megatron0000/solaris/estruturas/dual-axis-tracker/solartracker-bottom.dxf

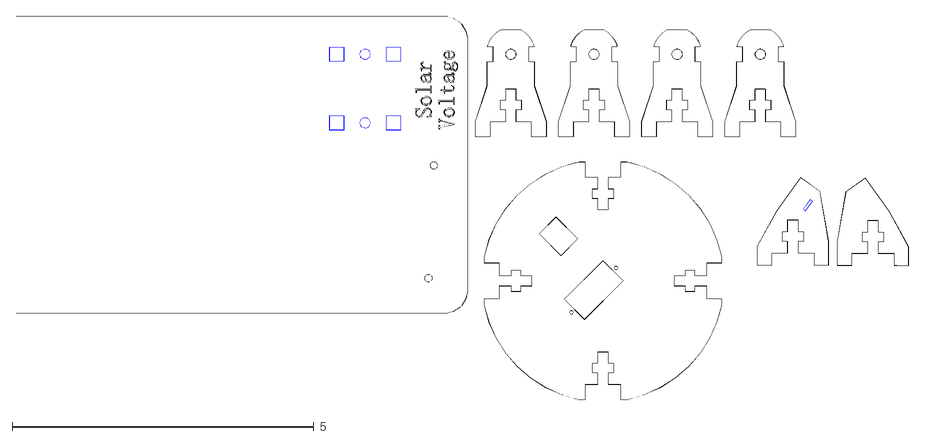
[picture p10: CAD file, 2017-06-11]
estruturas/dual-axis-tracker/solartracker-bottom.dxf
14.8 x 6.35
