megatron0000/solaris/estruturas/dual-axis-tracker/solartracker-top.dxf

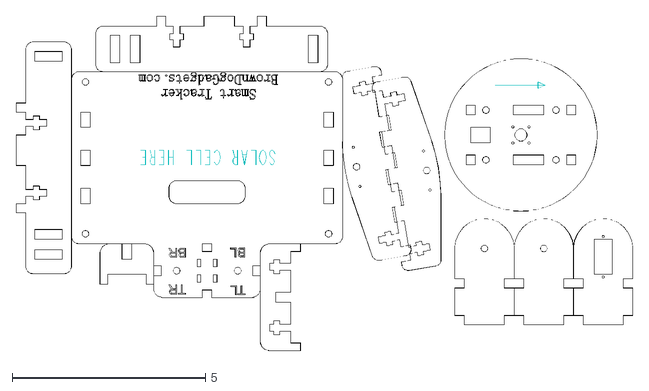
[picture p11: CAD file, 2017-06-11]
estruturas/dual-axis-tracker/solartracker-top.dxf
15.9 x 8.64
