megatron0000/solaris/estruturas/dual-axis-tracker/how-to-build.pdf

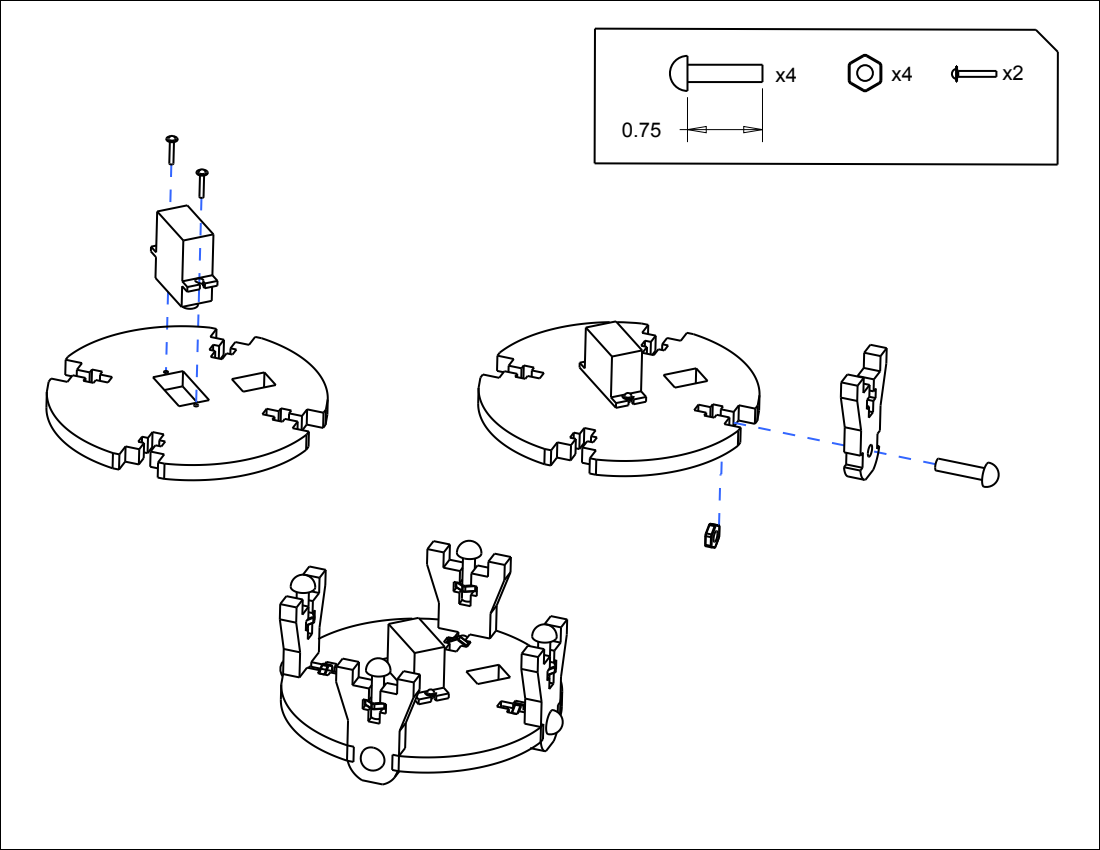
[picture p12: page 1]

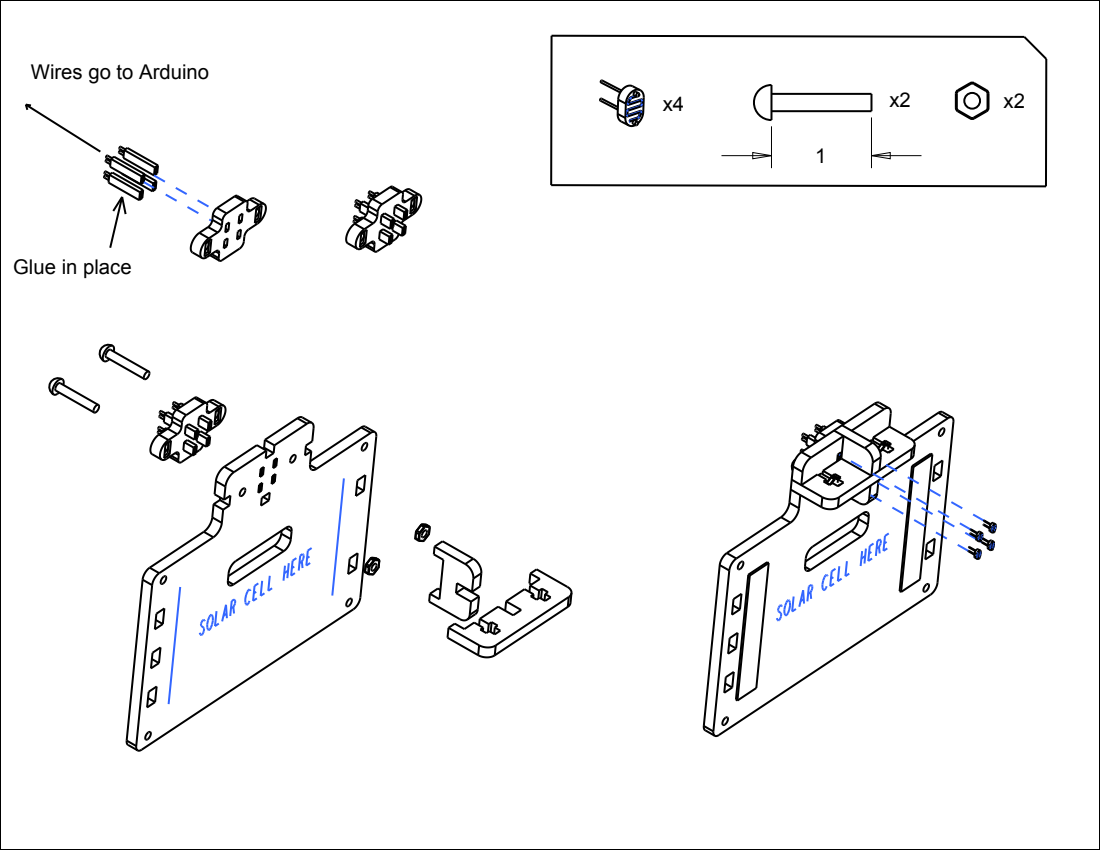
[picture p13: page 2]

Wires go to Arduino

Glue in place

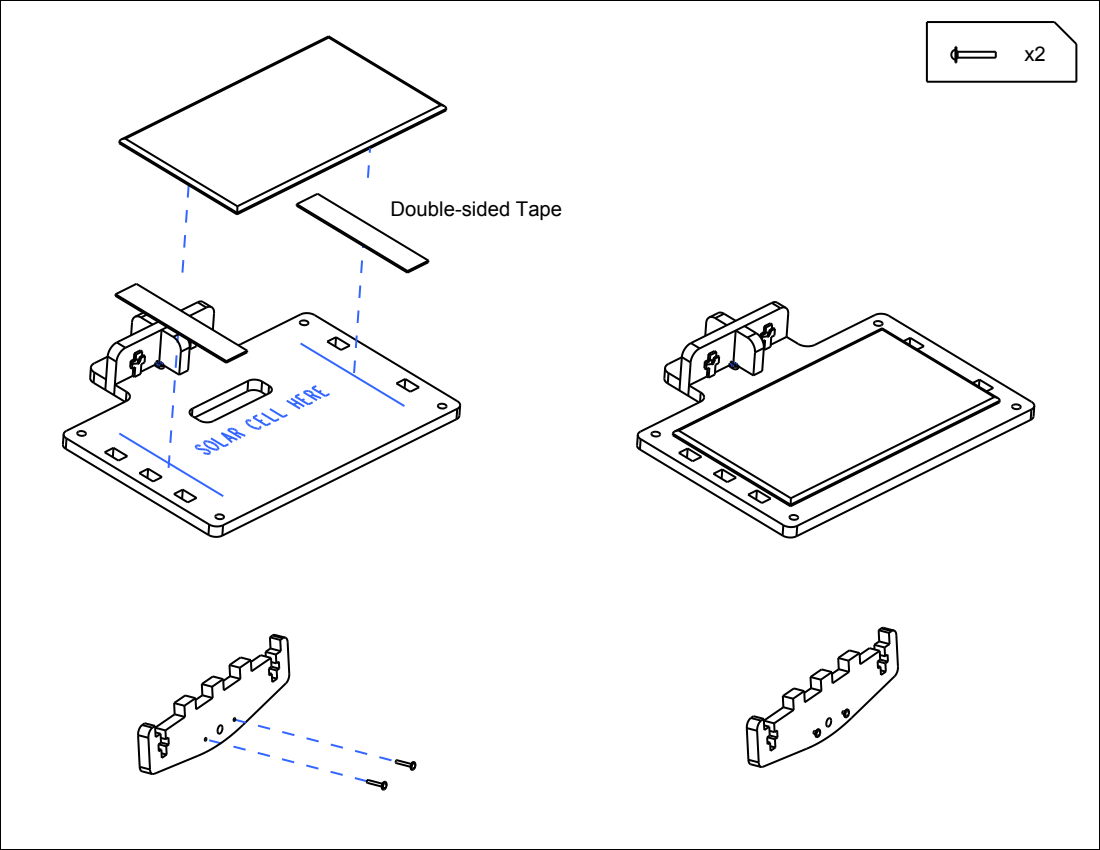
[picture p14: page 3]

Double-sided Tape

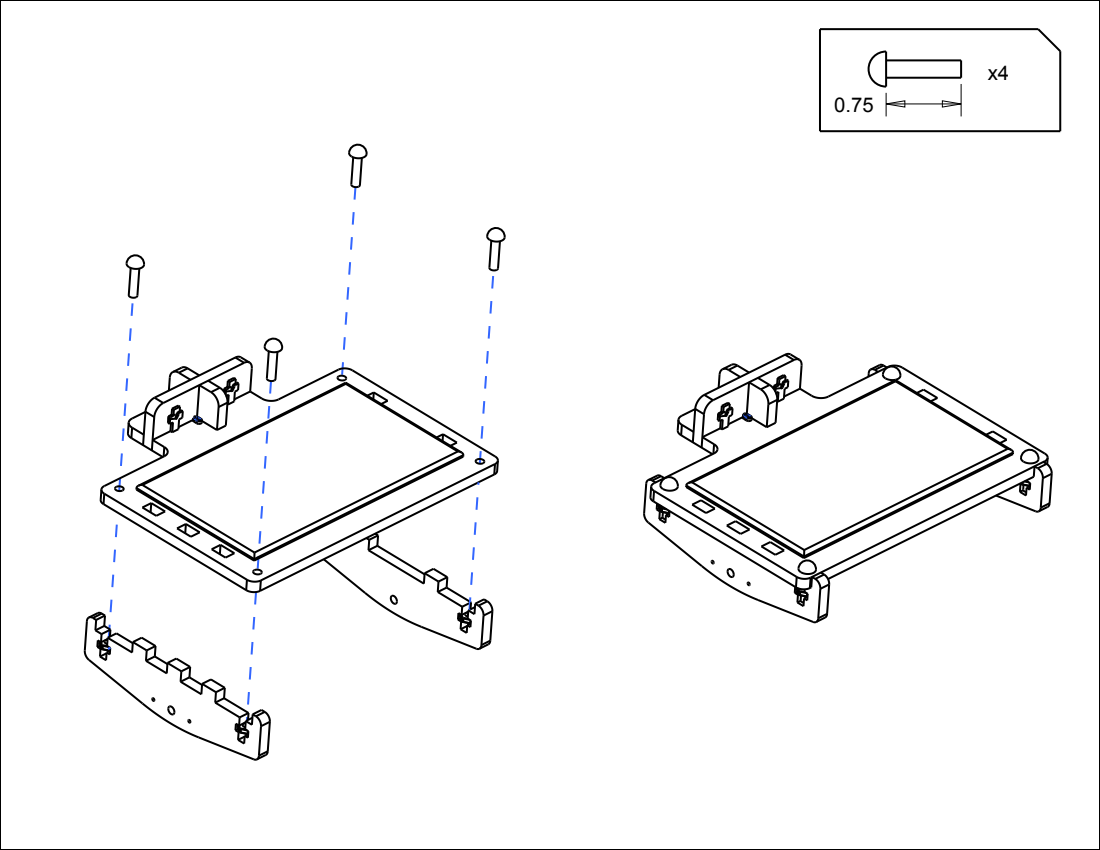
[picture p15: page 4]

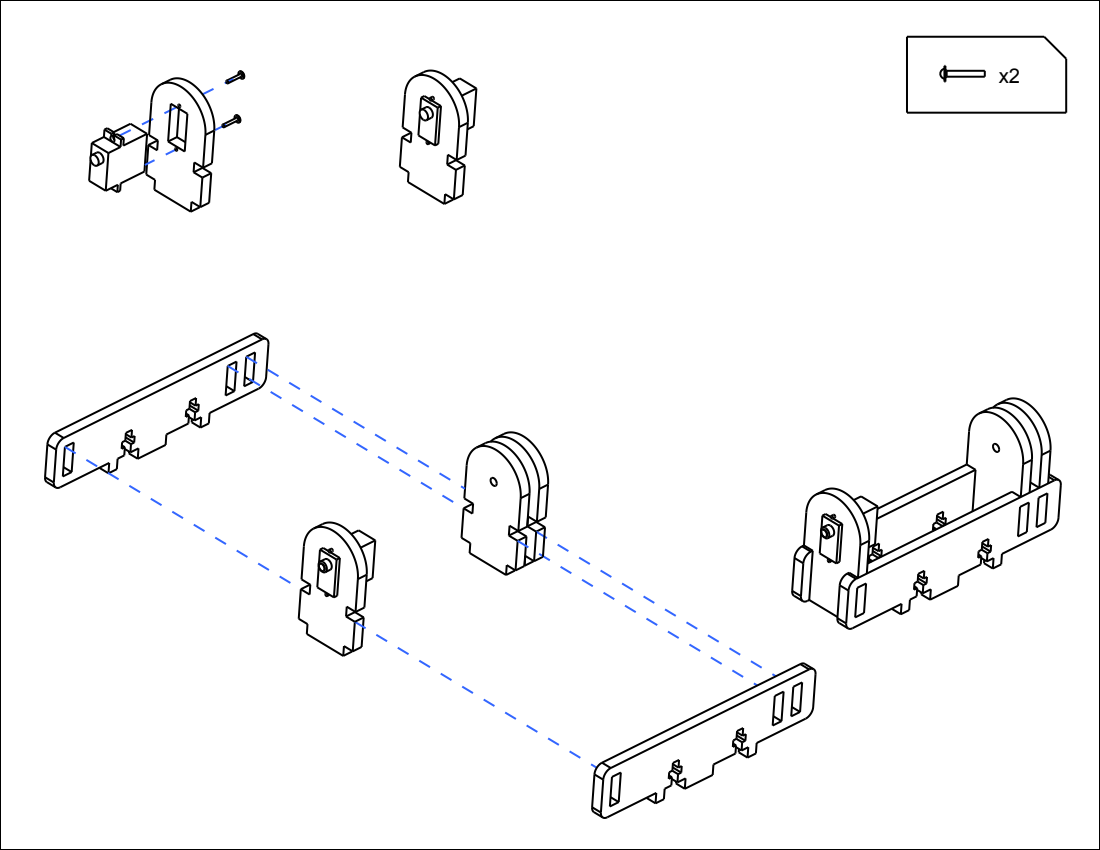
[picture p16: page 5]

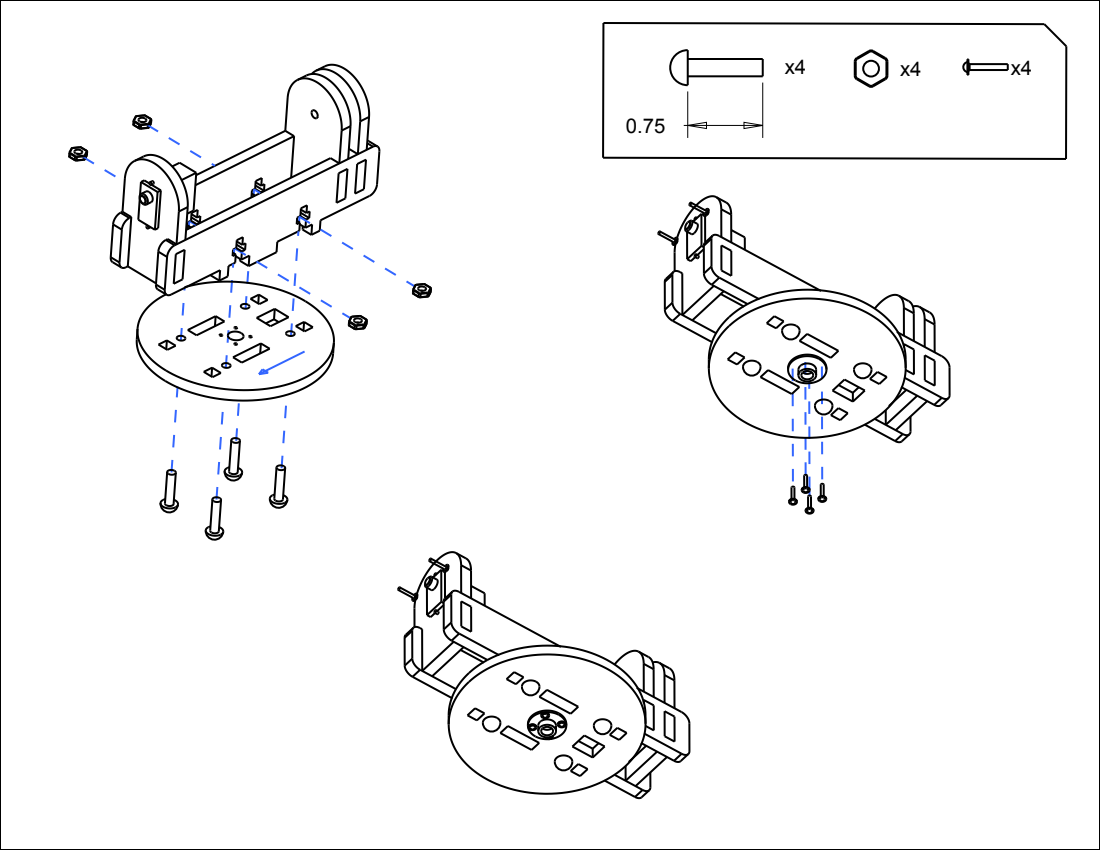
[picture p17: page 6]

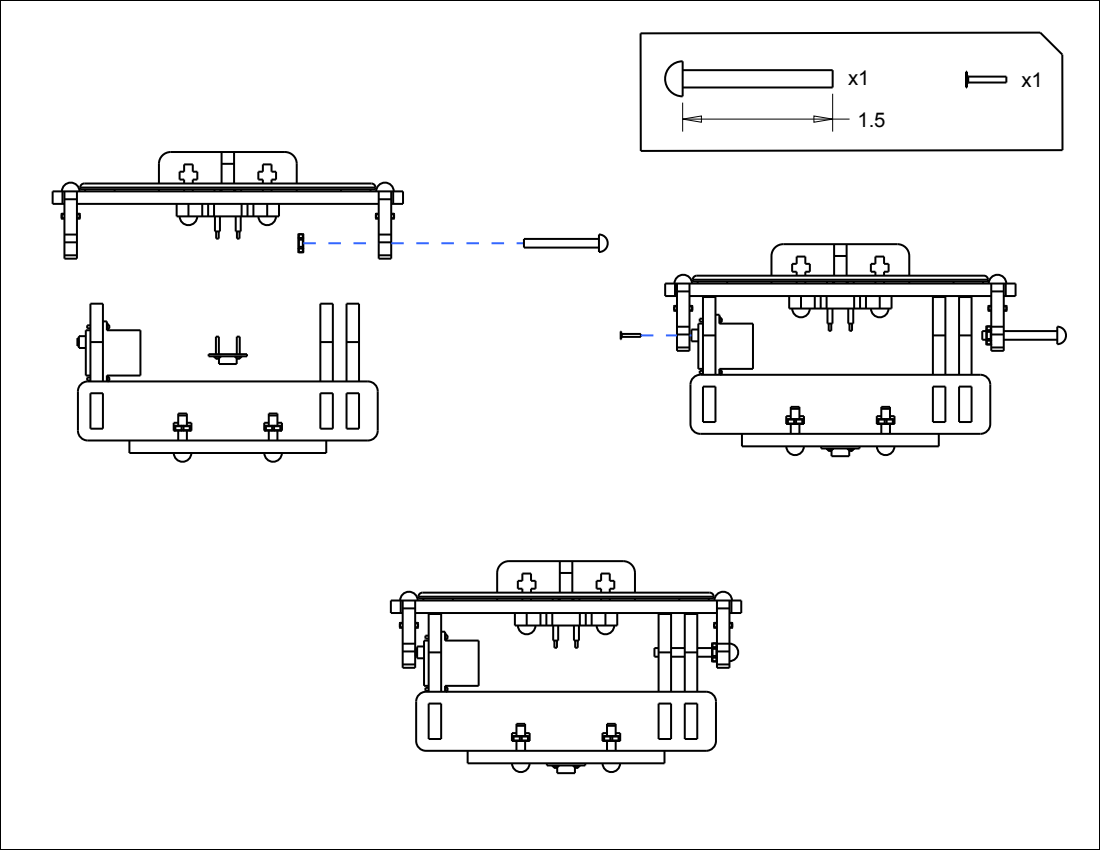
[picture p18: page 7]

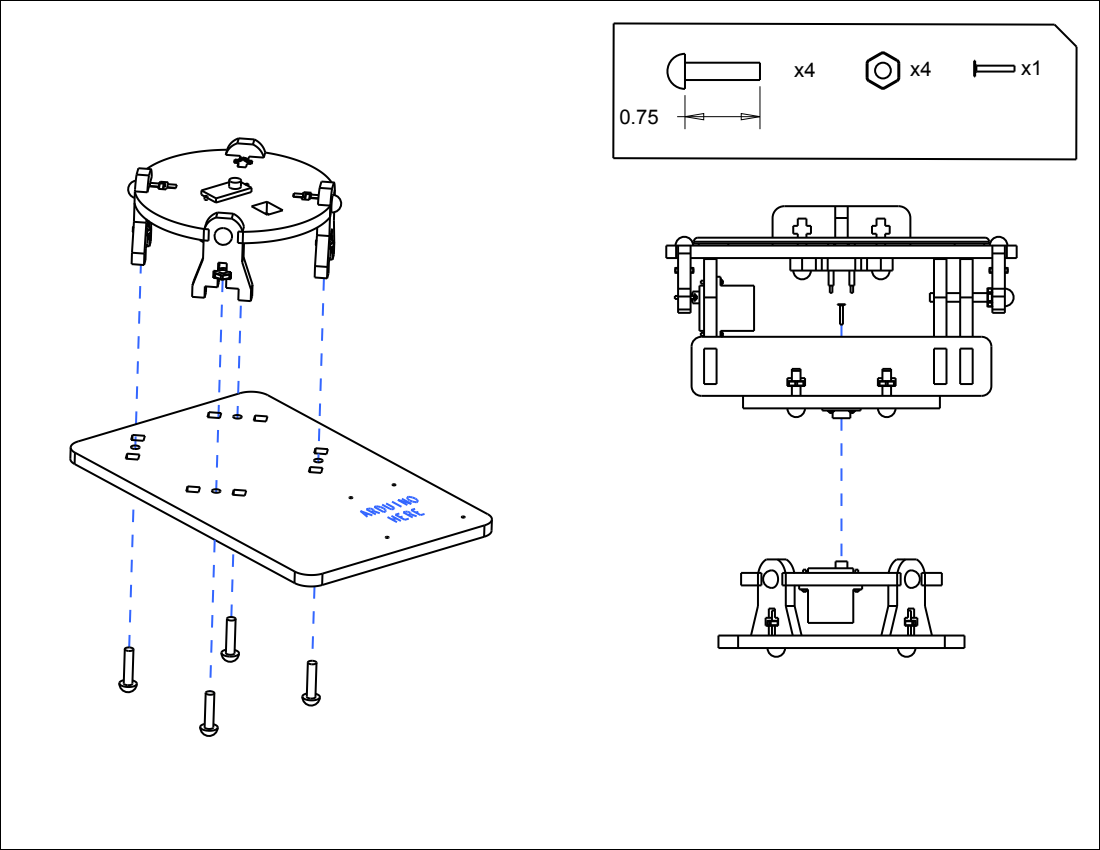
[picture p19: page 8]

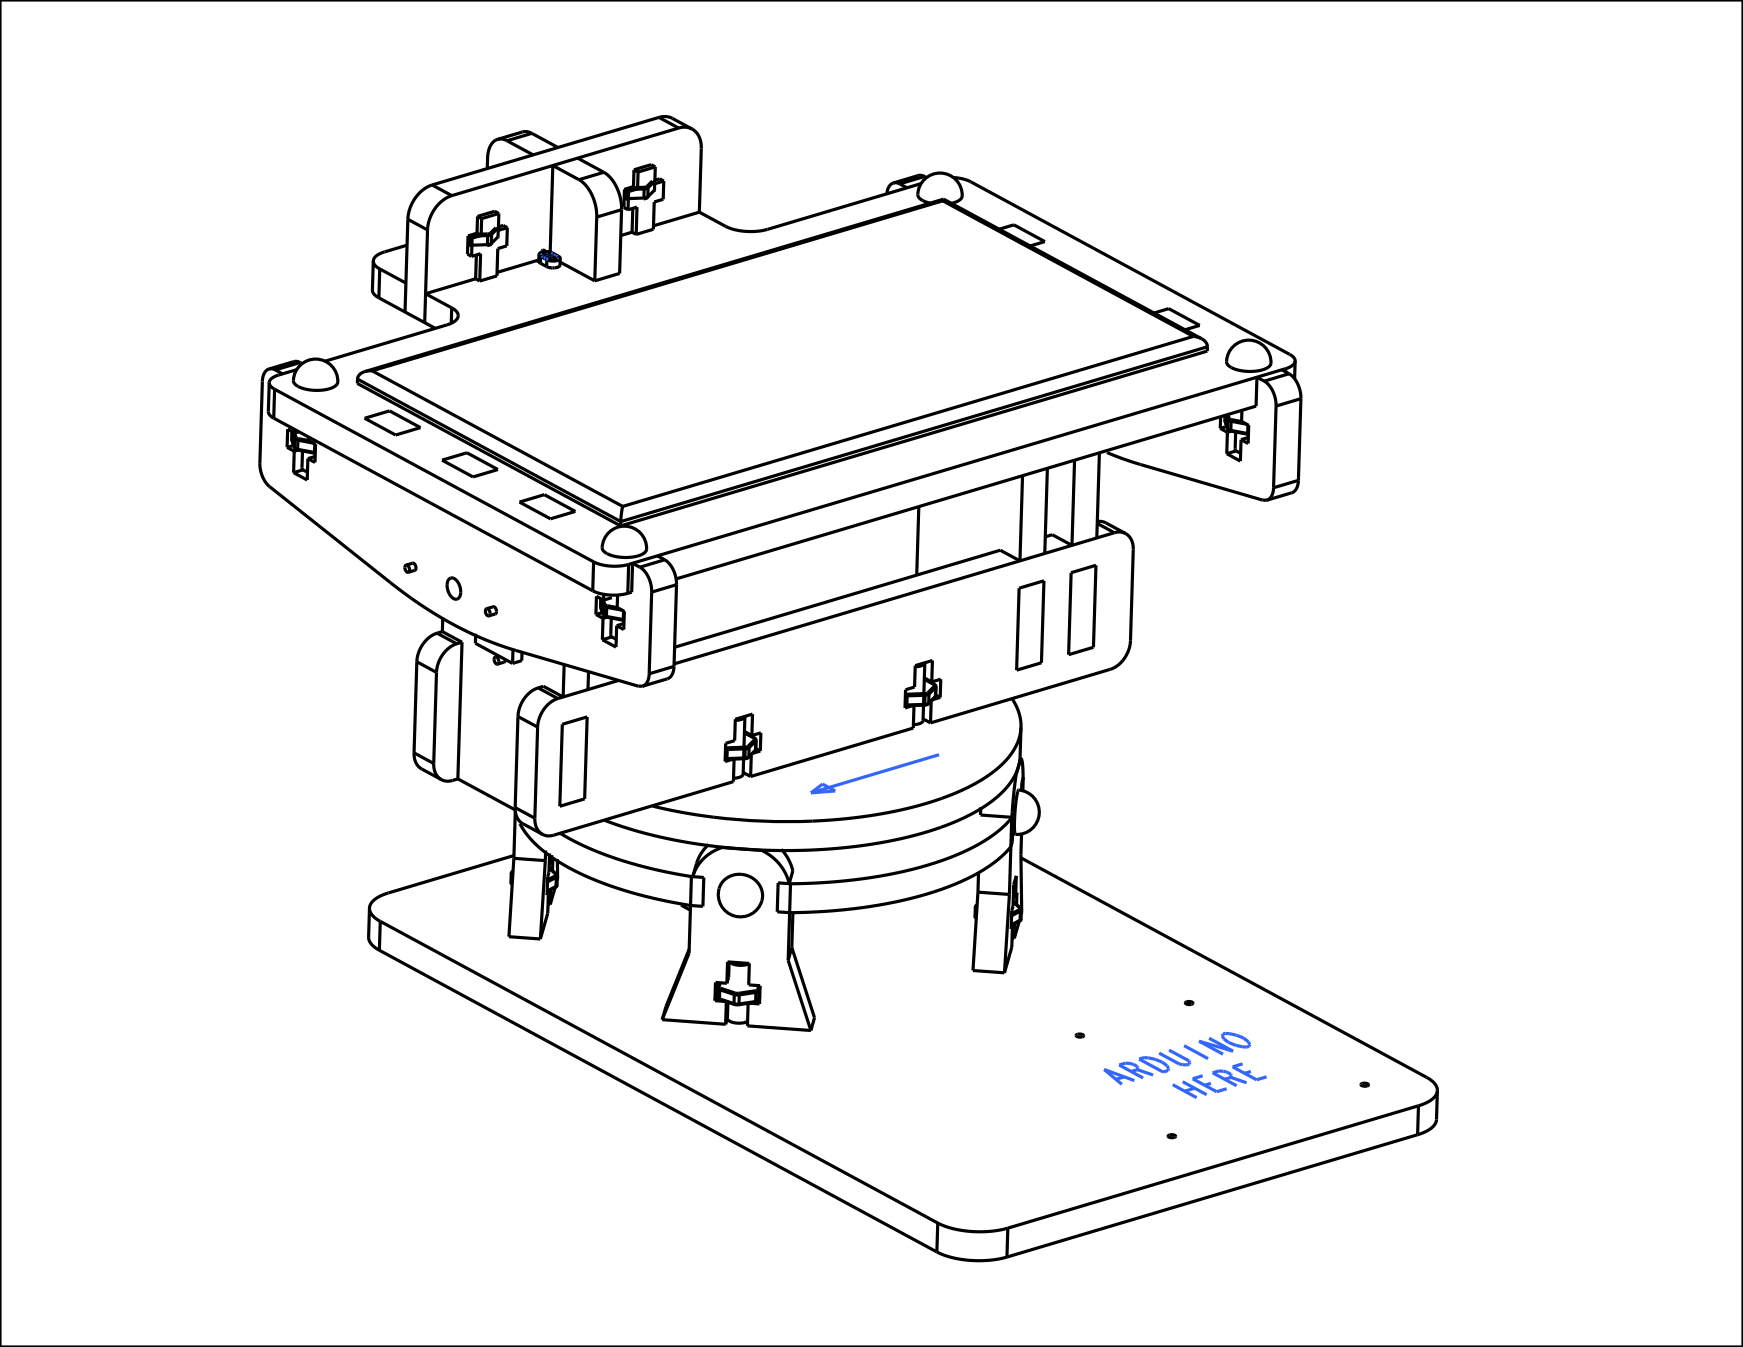
[picture p20: page 9]
