megatron0000/solaris/circuitos/SolarTracker-EagleProject/SolarTracker-EagleProject.sch

## EAGLE design circuitos/SolarTracker-EagleProject/SolarTracker-EagleProject.sch (2017-07-25)

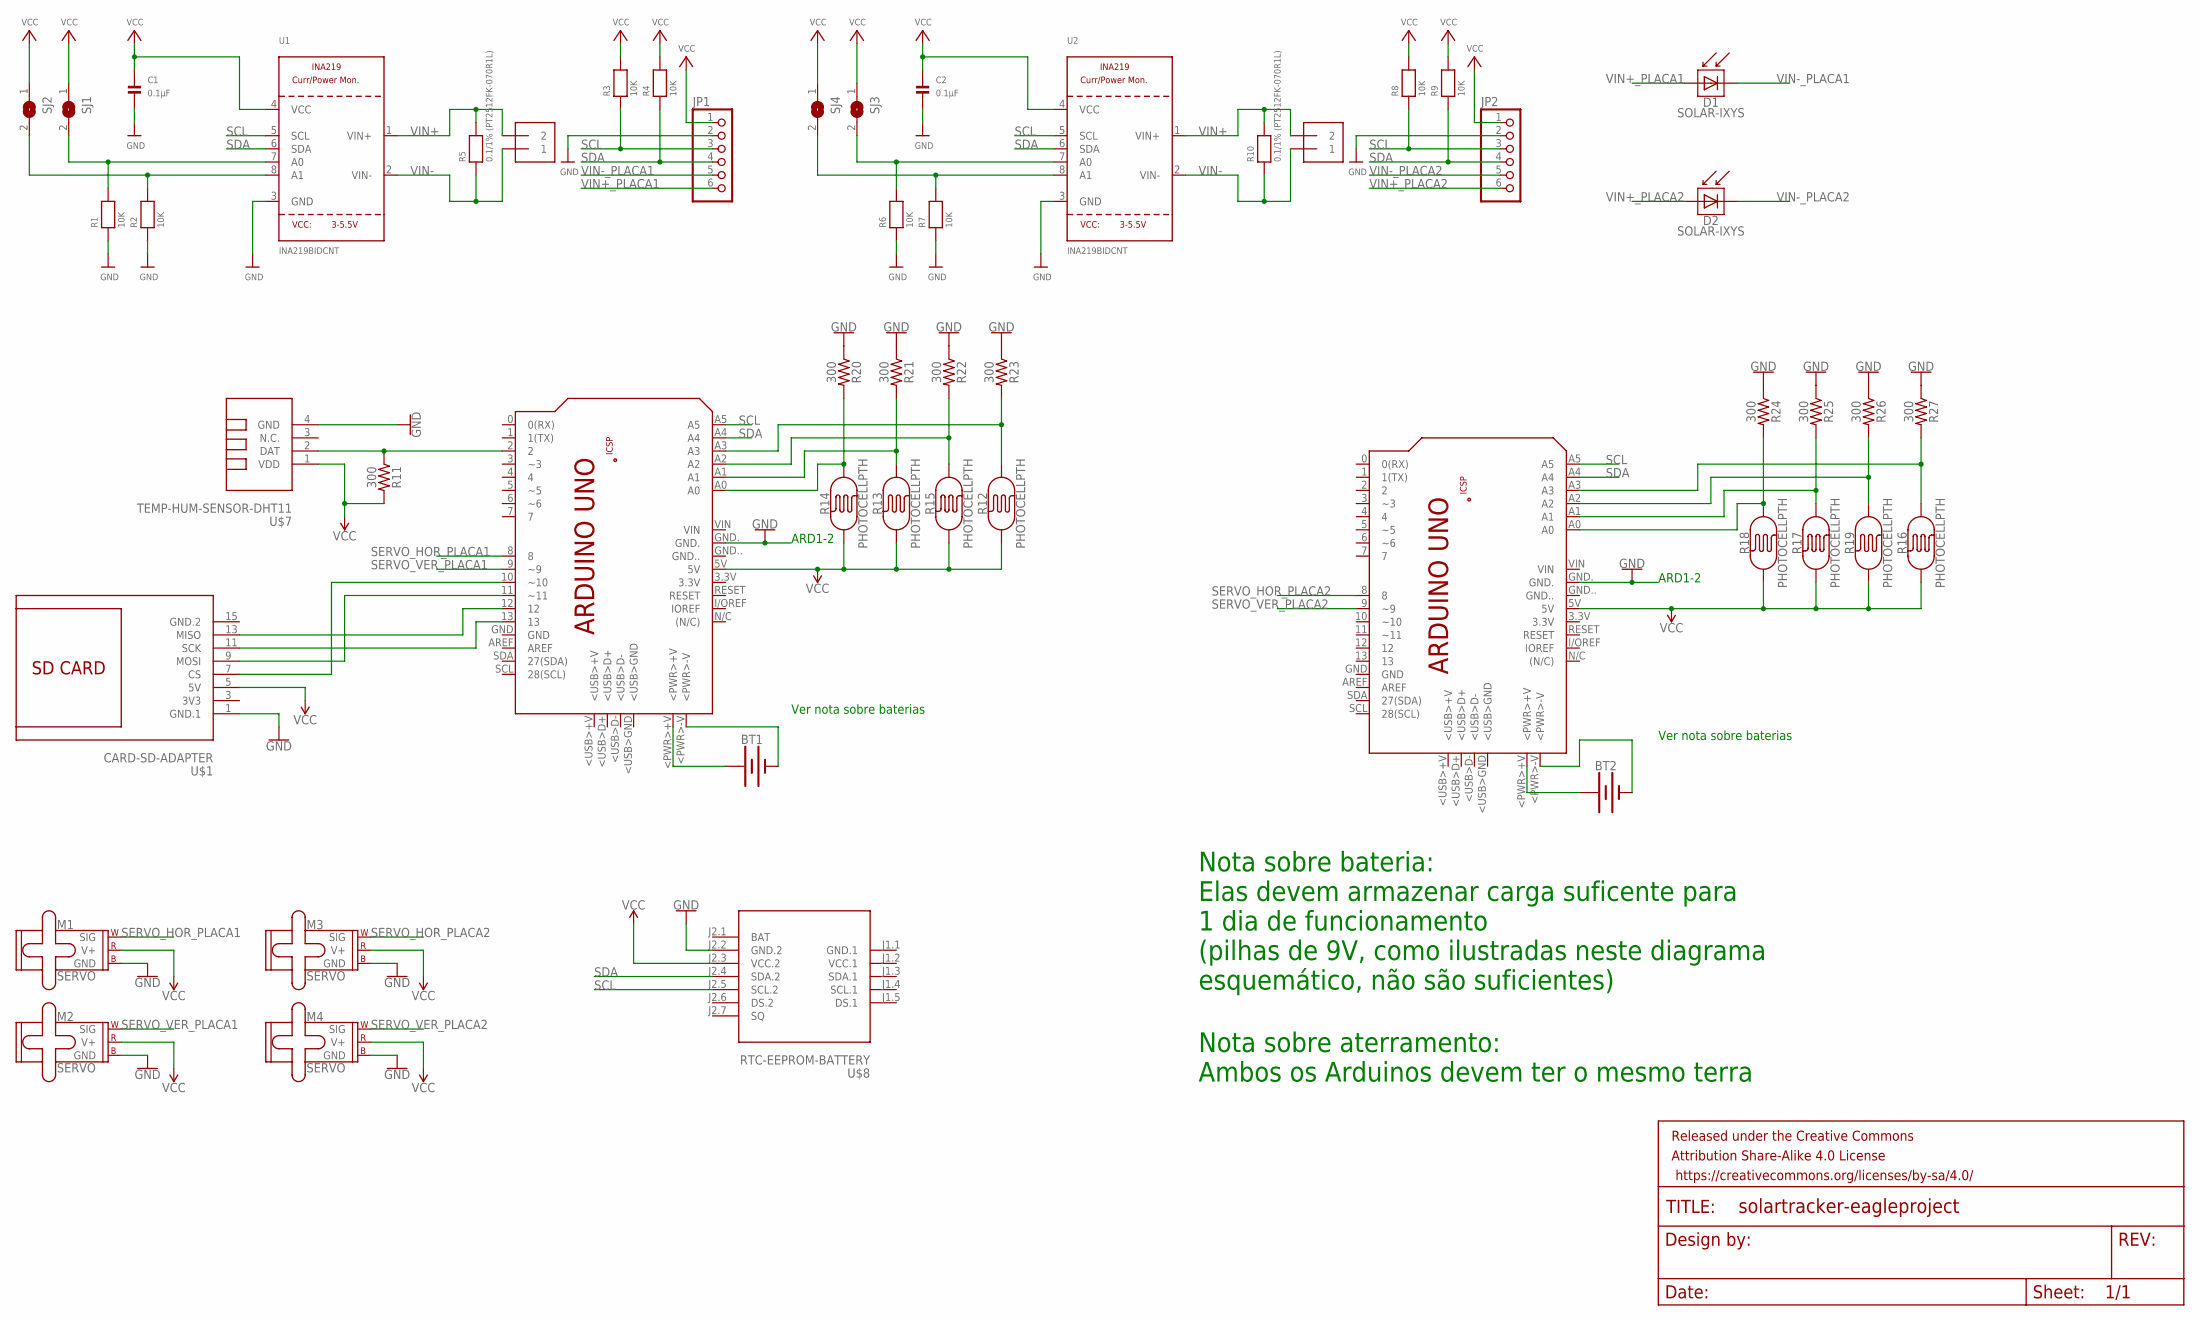
[picture p21: schematic SolarTracker-EagleProject.sch]

Parts:
BT1, BT2: BATTERY-9V; BATTCON_9V
C1, C2: 0.1µF; 0805
D1, D2: SOLAR-IXYS; SOIC-8
FRAME1: FRAME-LETTER; CREATIVE_COMMONS
J1, J2: TERMBLOCK_1X2-3.5MM; 1X2-3.5MM
JP1, JP2: HEADER-1X670MIL; 1X06_ROUND_70
M1, M2, M3, M4: SERVO; 1X03
PCB1, PCB2: ARDUINO_UNO
R1, R2, R3, R4, R6, R7, R8, R9: 10K; 0805
R5, R10: 0.1/1% (PT2512FK-070R1L); 2512
R11, R20, R21, R22, R23, R24, R25, R26, R27: 300; 0603
R12, R13, R14, R15, R16, R17, R18, R19: PHOTOCELLPTH; PHOTOCELL
SJ1, SJ2, SJ3, SJ4: SOLDERJUMPERREFLOW_NOPASTE; SOLDERJUMPER_REFLOW_NOPASTE
U1, U2: INA219BIDCNT; SOT23-8
U$1: CARD-SD-ADAPTER
U$7: TEMP-HUM-SENSOR-DHT11
U$8: RTC-EEPROM-BATTERY

Connections:
GND: C1.2, C2.2, JP1.2, JP2.2, M1.3 (GND), M2.3 (GND), M3.3 (GND), M4.3 (GND), PCB1.GND., PCB2.GND., R1.1, R2.1, R6.1, R7.1, R20.1, R21.1, R22.1, R23.1, R24.1, R25.1, R26.1, R27.1, U1.3 (GND), U2.3 (GND), U$1.1 (GND.1), U$7.4 (GND), U$8.J2.2 (GND.2)
unnamed: R2.2, SJ2.2, U1.8 (A1)
unnamed: R1.2, SJ1.2, U1.7 (A0)
unnamed: R7.2, SJ4.2, U2.8 (A1)
unnamed: R6.2, SJ3.2, U2.7 (A0)
unnamed: PCB1.13, U$1.11 (SCK)
unnamed: PCB1.12, U$1.13 (MISO)
unnamed: PCB1.11 (~11), U$1.9 (MOSI)
unnamed: PCB1.10 (~10), U$1.7 (CS)
unnamed: PCB1.2, R11.1, U$7.2 (DAT)
unnamed: PCB1.A0, R14.2, R20.2
unnamed: PCB1.A1, R13.2, R21.2
unnamed: BT2.+, PCB2.<PWR>+V
unnamed: BT2.-, PCB2.<PWR>-V
unnamed: BT1.+, PCB1.<PWR>+V
unnamed: BT1.-, PCB1.<PWR>-V
unnamed: PCB1.A2, R15.2, R22.2
unnamed: PCB1.A3, R12.2, R23.2
unnamed: PCB2.A0, R18.2, R24.2
unnamed: PCB2.A1, R17.2, R25.2
unnamed: PCB2.A2, R19.2, R26.2
unnamed: PCB2.A3, R16.2, R27.2
SCL: JP1.3, JP2.3, PCB1.A5, PCB2.A5, R3.1, R8.1, U1.5 (SCL), U2.5 (SCL), U$8.J2.5 (SCL.2)
SDA: JP1.4, JP2.4, PCB1.A4, PCB2.A4, R4.1, R9.1, U1.6 (SDA), U2.6 (SDA), U$8.J2.4 (SDA.2)
SERVO_HOR_PLACA1: M1.1 (SIG), PCB1.8
SERVO_HOR_PLACA2: M3.1 (SIG), PCB2.8
SERVO_VER_PLACA1: M2.1 (SIG), PCB1.9 (~9)
SERVO_VER_PLACA2: M4.1 (SIG), PCB2.9 (~9)
VCC: C1.1, C2.1, JP1.1, JP2.1, M1.2 (V+), M2.2 (V+), M3.2 (V+), M4.2 (V+), PCB1.5V, PCB2.5V, R3.2, R4.2, R8.2, R9.2, R11.2, R12.1, R13.1, R14.1, R15.1, R16.1, R17.1, R18.1, R19.1, SJ1.1, SJ2.1, SJ3.1, SJ4.1, U1.4 (VCC), U2.4 (VCC), U$1.5 (5V), U$7.1 (VDD), U$8.J2.3 (VCC.2)
VIN+: J1.2, J2.2, R5.2, R10.2, U1.1 (VIN+), U2.1 (VIN+)
VIN+_PLACA1: D1.8 (A), JP1.6
VIN+_PLACA2: D2.8 (A), JP2.6
VIN-: J1.1, J2.1, R5.1, R10.1, U1.2 (VIN-), U2.2 (VIN-)
VIN-_PLACA1: D1.5 (C), JP1.5
VIN-_PLACA2: D2.5 (C), JP2.5

Notes on the sheet:
ARD1-2
Ver nota sobre baterias
Nota sobre bateria: Elas devem armazenar carga suficente para 1 dia de funcionamento (pilhas de 9V, como ilustradas neste diagrama esquemático, não são suficientes)
Nota sobre aterramento: Ambos os Arduinos devem ter o mesmo terra
