megatron0000/solaris/codigos/Arduino_Sun_Position_Calculations/Arduino_Sun_Position_Calculations.ino

//////////////////////////////////////////////////  
//PUT YOUR LATITUDE, LONGITUDE, AND TIME ZONE HERE
  float latitude = -23.2237;
  float longitude = -45.9009;
  float timezone = -3;
//////////////////////////////////////////////////  
  
//If you live in the southern hemisphere, it would probably be easier
//for you if you make north as the direction where the azimuth equals
//0 degrees. To do so, switch the 0 below with 180.  
  float northOrSouth = 180;

/////////////////////////////////////////////////////////// 
//MISC. VARIABLES
///////////////////////////////////////////////////////////  
  float pi = 3.14159265;
  float altitude;
  float azimuth;
  float delta;
  float h;
/////////////////////////////////////////////////////////// 
//END MISC. VARIABLES
///////////////////////////////////////////////////////////
  
void setup(){
  Serial.begin(9600);
  latitude = latitude * pi/180;
}

void loop(){

  float month2;
  float day;
  float hour2;
  float minute2;

  //SET TIME AND DATE HERE//////////////
  month2 = 3;
  day = 7;
  hour2 = 17;//Use 24hr clock (ex: 1:00pm = 13:00) and don't use daylight saving time.
  minute2 = 18;
  //END SET TIME AND DATE /////////////


  //START OF THE CODE THAT CALCULATES THE POSITION OF THE SUN

  //NUMBER OF DAYS SINCE THE START OF THE YEAR. 
  float n = daynum(month2) + day;

  //SUN'S DECLINATION.
  delta = .409279 * sin(2 * pi * ((284 + n)/365.25));
  
  //TAKES THE CURRENT DAY OF THE MONTH AND CHANGES IT TO A LOOK UP VALUE ON THE HOUR ANGLE TABLE.
  day = dayToArrayNum(day);
  
  //FINDS THE NOON HOUR ANGLE ON THE TABLE AND MODIFIES IT FOR THE USER'S OWN LOCATION AND TIME ZONE.
  h = (FindH(day,month2)) + longitude + (timezone * -1 * 15);
  //FURTHER MODIFIES THE NOON HOUR ANGLE OF THE CURRENT DAY AND TURNS IT INTO THE HOUR ANGLE FOR THE CURRENT HOUR AND MINUTE.
  h = ((((hour2 + minute2/60) - 12) * 15) + h)*pi/180;

  //FINDS THE SUN'S ALTITUDE.
  altitude = (asin(sin(latitude) * sin(delta) + cos(latitude) * cos(delta) * cos(h)))*180/pi;

  //FINDS THE SUN'S AZIMUTH.
  azimuth = ((atan2((sin(h)),((cos(h) * sin(latitude)) - tan(delta) * cos(latitude)))) + (northOrSouth*pi/180)) *180/pi;
  

  Serial.println("Altitude");
  Serial.println(altitude);  
  Serial.println("Azimuth");
  Serial.println(azimuth);
  delay(5000);

}
