megatron0000/solaris/codigos/Arduino_Sun_Position_Calculations/Table.ino

//THIS CODE TURNS THE MONTH INTO THE NUMBER OF DAYS SINCE JANUARY 1ST.
//ITS ONLY PURPOSE IS FOR CALCULATING DELTA (DECLINATION), AND IS NOT USED IN THE HOUR ANGLE TABLE OR ANYWHERE ELSE.
float daynum(float month) {
  float day;
  if (month == 1) {
    day = 0;
  }
  if (month == 2) {
    day = 31;
  }
  if (month == 3) {
    day = 59;
  }
  if (month == 4) {
    day = 90;
  }
  if (month == 5) {
    day = 120;
  }
  if (month == 6) {
    day = 151;
  }
  if (month == 7) {
    day = 181;
  }
  if (month == 8) {
    day = 212;
  }
  if (month == 9) {
    day = 243;
  }
  if (month == 10) {
    day = 273;
  }
  if (month == 11) {
    day = 304;
  }
  if (month == 12) {
    day = 334;
  }
  return day;
}

//THIS CODE TAKES THE DAY OF THE MONTH AND DOES ONE OF THREE THINGS: ADDS A DAY, SUBTRACTS A DAY, OR
//DOES NOTHING. THIS IS DONE SO THAT LESS VALUES ARE REQUIRED FOR THE NOON HOUR ANGLE TABLE BELOW.
int dayToArrayNum(int day) {
  if ((day == 1)  || (day == 2)  || (day == 3)) {
    day = 0;
  }
  if ((day == 4)  || (day == 5)  || (day == 6)) {
    day = 1;
  }
  if ((day == 7)  || (day == 8)  || (day == 9)) {
    day = 2;
  }
  if ((day == 10) || (day == 11) || (day == 12)) {
    day = 3;
  }
  if ((day == 13) || (day == 14) || (day == 15)) {
    day = 4;
  }
  if ((day == 16) || (day == 17) || (day == 18)) {
    day = 5;
  }
  if ((day == 19) || (day == 20) || (day == 21)) {
    day = 6;
  }
  if ((day == 22) || (day == 23) || (day == 24)) {
    day = 7;
  }
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
    };
    h = h_Array[day];
  }

  if (month == 12) {
    float h_Array[10] = {
      2.325, 2.004, 1.665, 1.312, 0.948, 0.578, 0.205, -0.167, -0.534, -0.893,
    };
    h = h_Array[day];
  }

  return h;
}
//////////////////////////////////////////////////////////////
