megatron0000/solaris/codigos/testes/i2c-test/i2c-master/i2c-master.ino

#include <DS3231.h>
#include <Wire.h>

void setup()
{
  // Setup Serial connection
  Serial.begin(9600);

  Wire.begin(); // join i2c bus (address optional for master)
}

byte x = 0;

void loop()
{

  Wire.beginTransmission(8); // transmit to device #8
  Wire.write("x is ");        // sends five bytes
  Wire.write(x);              // sends one byte
  Wire.endTransmission();    // stop transmitting
  x++;
  delay(500);
}
