megatron0000/solaris/(commit log)

2017-06-11 Versão inicial de fim da 5ª semana
    [Base_Gear_Shaft.stl, Base_Gear_and_Panel_Mount.stl, Horz_Servo_Gear.stl, LDR_Divider.stl, Panel_Bracket.stl, Tracker_Base.stl, Vertical_Servo_Gear.stl, solartracker-bottom.dxf]
2017-06-11 Corrige pinos dos servos. Insere random na atualização angular dos servos. Define leituras dos LDR como float. Define tolerância (tol) como float.
    [sensor-track.ino, servo-test.ino]
2017-06-11 Aumenta máx. angulação de servov. Corrige i2c-master.ino para só usar Wire (não RTC).
    [i2c-master.ino, sensor-track.ino]
2017-06-11 Aprimora master-arduino.ino. Reorganiza diretórios.
2017-06-12 Finaliza master-arduino.ino. Arduino mestre lê sensores, escreve no SD e controla seu par de servos. Retira componentes SD de sensor-track.ino (passa a só controlar servos). Exclui gear-sensor-tracke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
    [Base_Gear_Shaft.stl, Base_Gear_and_Panel_Mount.stl, Horz_Servo_Gear.stl, LDR_Divider.stl, Panel_Bracket.stl, Tracker_Base.stl, Vertical_Servo_Gear.stl]
2017-07-25 Adiciona algoritmo de cálculo de posição solar. Retira random (que tentava corrigir overshoot). Redefine tempo cíclico usando TIME_LENGTH (máximo agora é 60).
    [Arduino_Sun_Position_Calculations.ino, Table.ino, ds3231-test.ino, ldr-test.ino, master-arduino.ino, sensor-track.ino, servo-test.ino]
2017-07-25 Adiciona esquemático EAGLE. Inicia documentação geral.
    [SolarTracker-EagleProject.sch]
2017-07-26 Reorganiza diretórios drasticamente. Atualiza documentação geral.
    [SolarTracker-EagleProject.sch, solartracker-bottom.dxf, solartracker-top.dxf]
